SeeedDocument/CAN-BUS-Shield-V2.0/img/CANBUS_V2_Hardware_overview.png

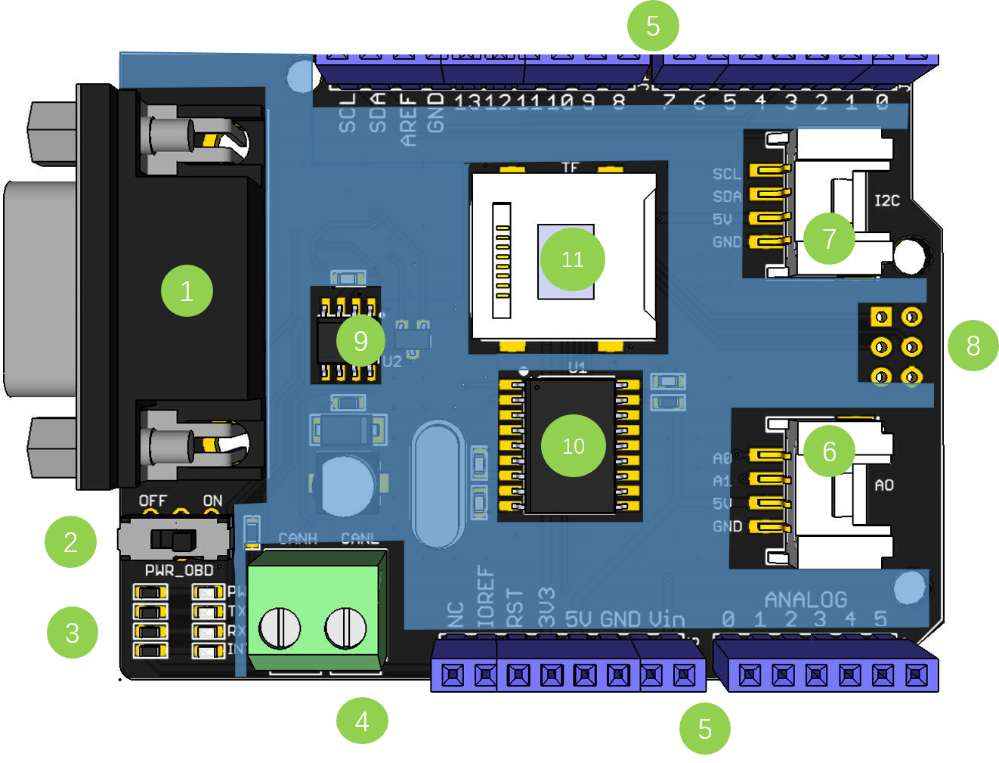
img/CANBUS_V2_Hardware_overview.png
