SeeedDocument/CAN-BUS-Shield-V2.0/img/cs_view.png

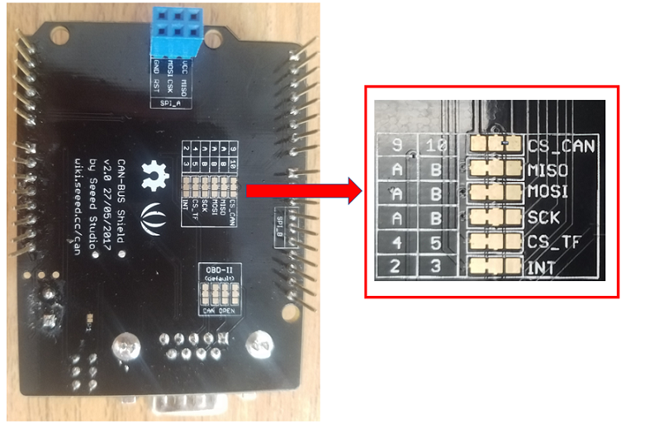
img/cs_view.png
