SeeedDocument/CAN-BUS-Shield-V2.0/img/CAN_BUS_Shield_V2.jpg

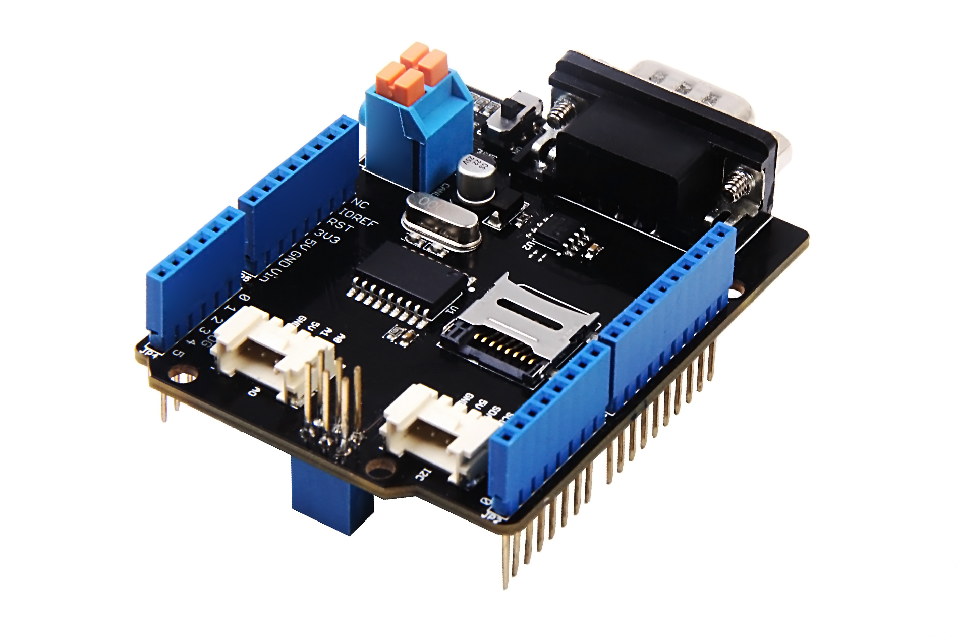
img/CAN_BUS_Shield_V2.jpg
