SeeedDocument/CAN-BUS-Shield-V2.0/img/canbus_arduino.png

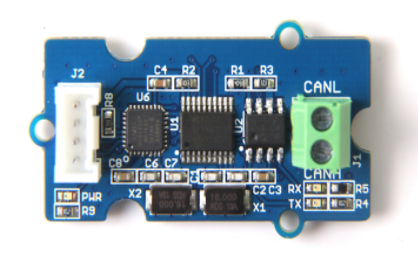
img/canbus_arduino.png
