SeeedDocument/CAN-BUS-Shield-V2.0/img/CP-602U-I_Pin.jpg

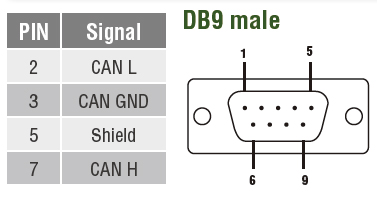
img/CP-602U-I_Pin.jpg
