SeeedDocument/CAN-BUS-Shield-V2.0/img/cs_cut.png

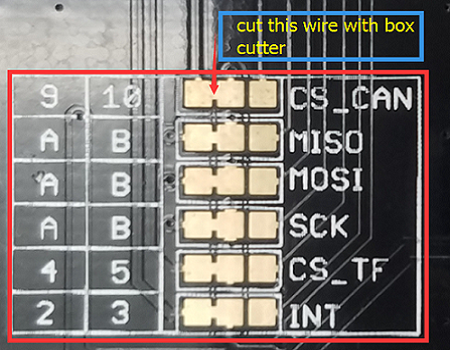
img/cs_cut.png
