SeeedDocument/CAN-BUS-Shield-V2.0/img/drawing2.png

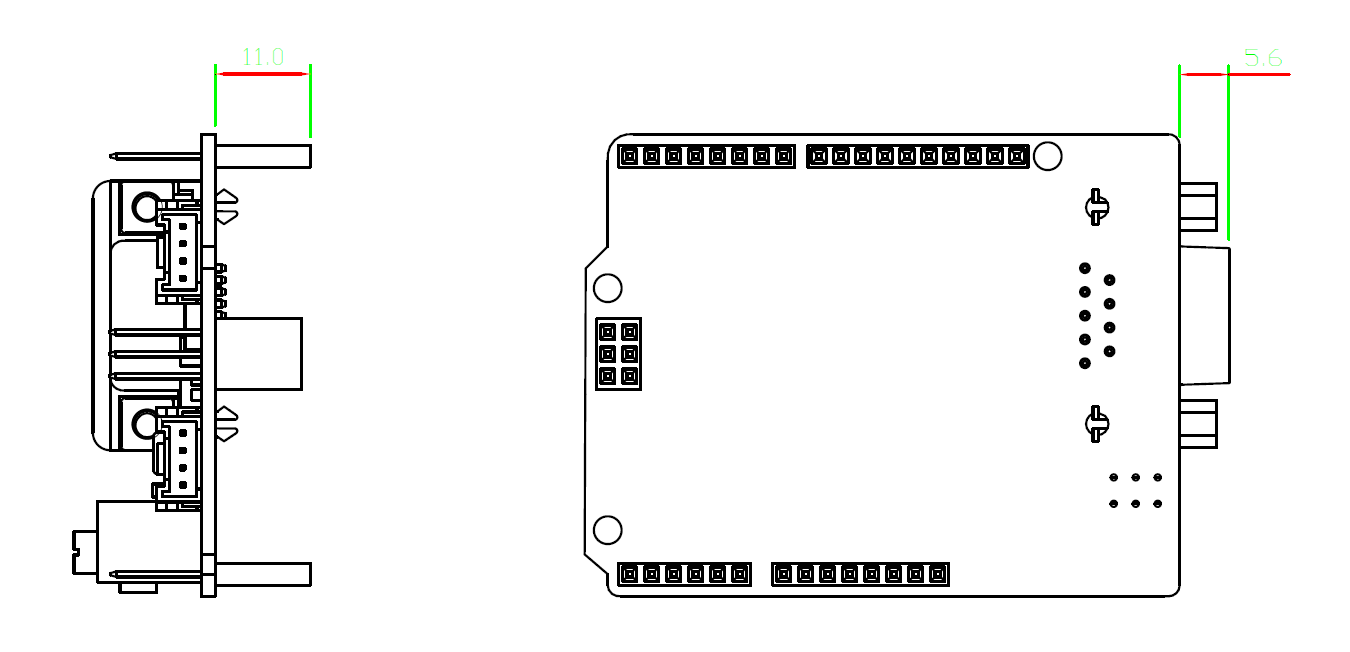
img/drawing2.png
