SeeedDocument/CAN-BUS-Shield-V2.0/img/INT_1.png

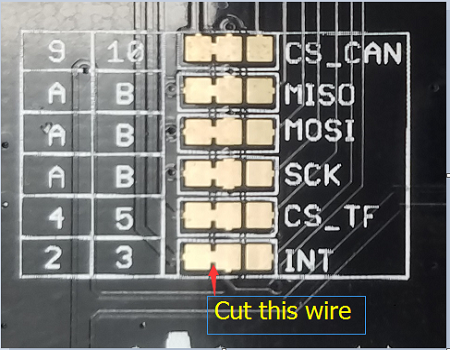
img/INT_1.png
