SeeedDocument/CAN-BUS-Shield-V2.0/img/INT_2.png

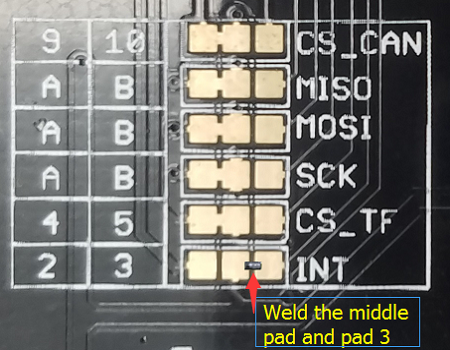
img/INT_2.png
