SeeedDocument/CAN-BUS-Shield-V2.0/img/ODB.png

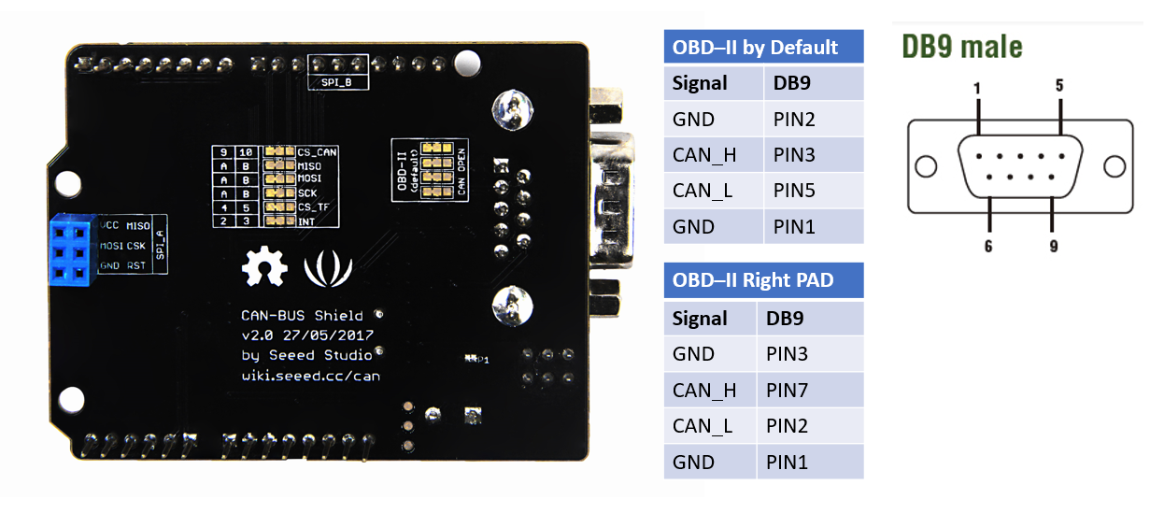
img/ODB.png
