SeeedDocument/CAN-BUS-Shield-V2.0/img/PingMAP_CANBUS_V2.png

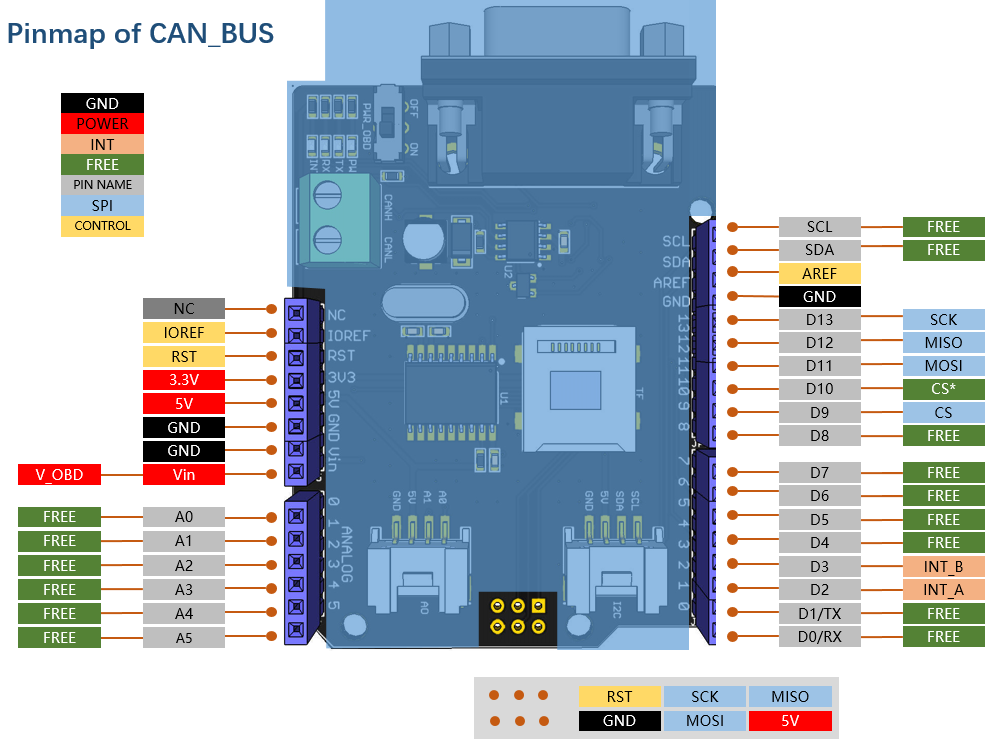
img/PingMAP_CANBUS_V2.png
