SeeedDocument/CAN-BUS-Shield-V2.0/img/weld_cs.png

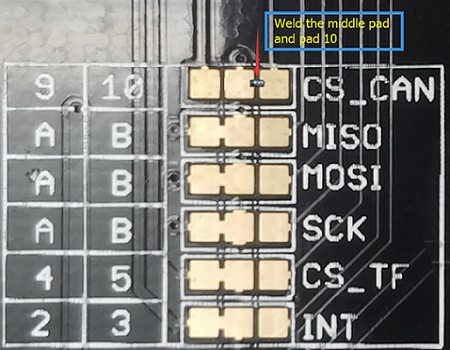
img/weld_cs.png
