SeeedDocument/CAN-BUS-Shield-V2.0/res/CAN-BUS Shield  v2.0.brd

## EAGLE design res/CAN-BUS Shield v2.0.brd

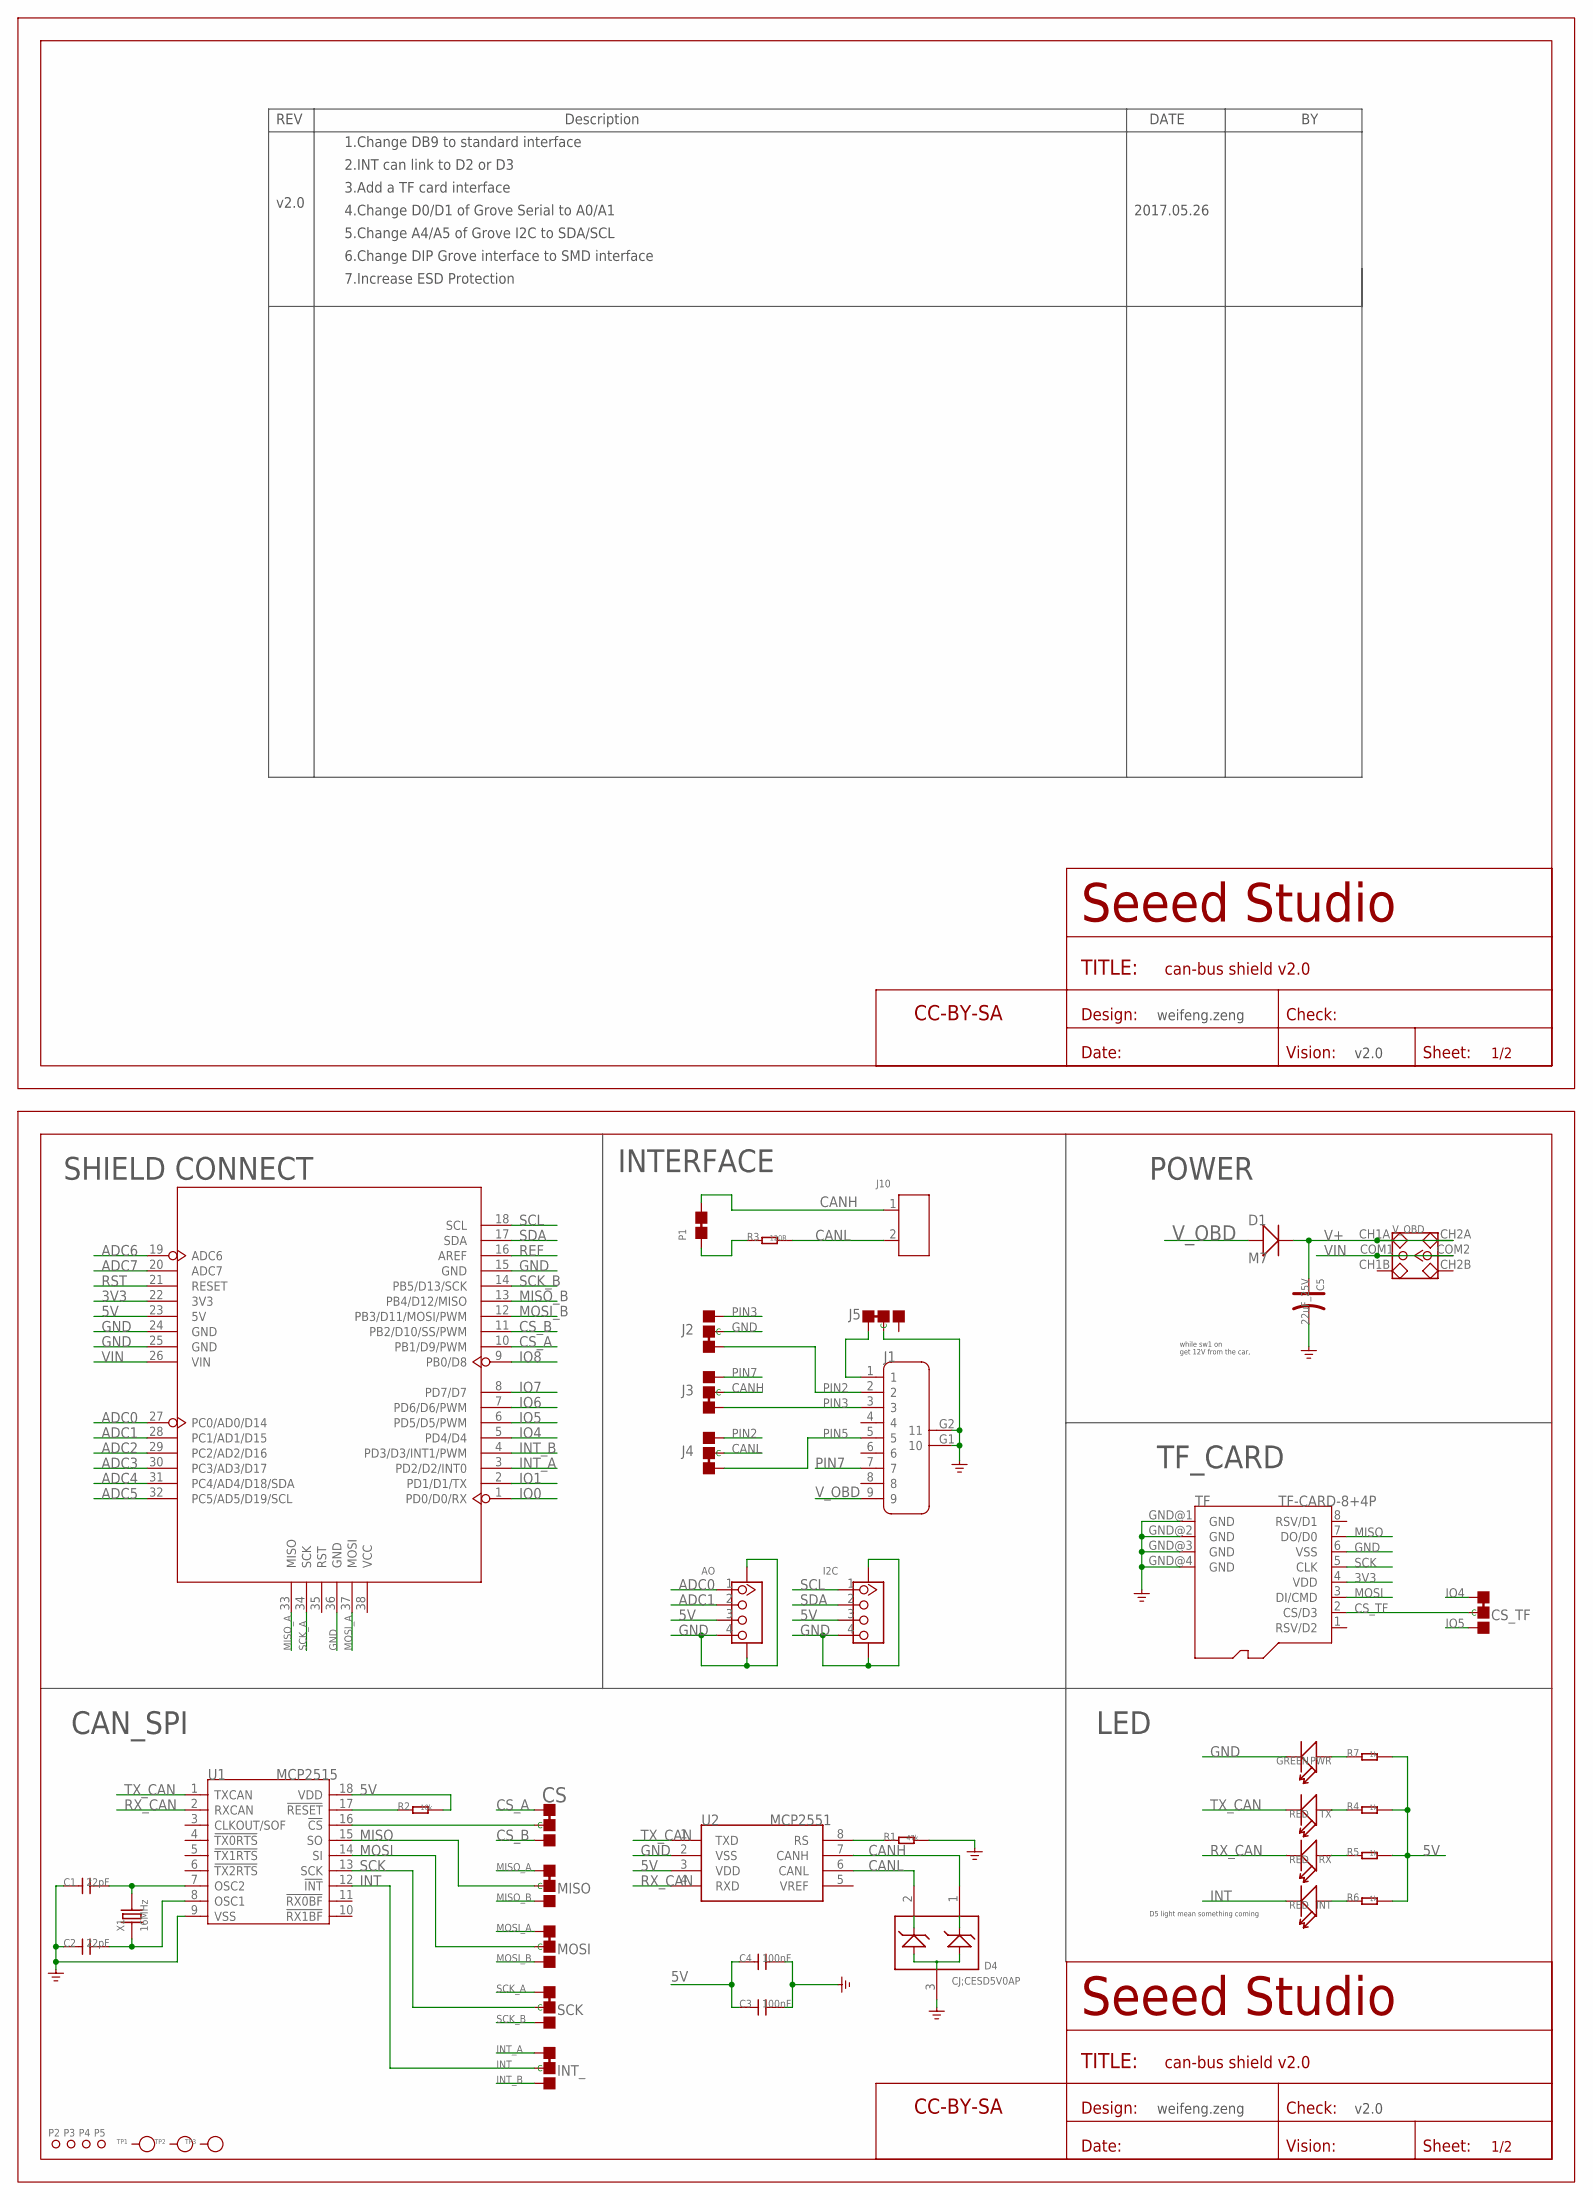
[picture p15: schematic CAN-BUS Shield v2.0.sch, sheet 1]

Parts:
AO: GROVE-CONNECTOR-SMD'90D'; HW4-SMD-2.0-90D
C1, C2: 22pF; 0603
C3, C4: 100nF; 0603
C5: 22uF_25V; ELECTRO-SMD-B-4.8MM
CS: JUMPER-3P-SHORT; 3P-SMD-SHORT
CS_TF: JUMPER-3P-SHORT; 3P-SMD-SHORT
D1: M7; D2010
D4: CJ;CESD5V0AP; SOT-23
I2C: GROVE-CONNECTOR-SMD'90D'; HW4-SMD-2.0-90D
INT: RED; LED-0603
INT_: JUMPER-3P-SHORT; 3P-SMD-SHORT
J1: DB9'MEAL'; DB9-MEAL
J2, J3, J4, J5: JUMPER-3P-SHORT; 3P-SMD-SHORT
J10: SCREW-TERMINAL-2P-10.6X10; H2-5.0-10.6X10X14.8H
MISO: JUMPER-3P-SHORT; 3P-SMD-SHORT
MOSI: JUMPER-3P-SHORT; 3P-SMD-SHORT
P1: JUMPER-2P-SHORT; 2P-SMD-SHORT
P2, P3, P4, P5: PAD-MARK'ANNULAR'; ROUND-MARK-1.0
PWR: GREEN; LED-0603
R1: 47k; 0603
R2: 10k; 0603
R3: 120R; 0603
R4, R5, R6, R7: 1k; 0603
RX: RED; LED-0603
SCK: JUMPER-3P-SHORT; 3P-SMD-SHORT
TF: TF-CARD-8+4P; TF-8+4P-1.1-13.5X15MM
TP1, TP2, TP3: PAD-TEST-POINT'4545'; TP_4545
TX: RED; LED-0603
U1: MCP2515; SOIC18
U2: MCP2551; SOIC8-6.0
U4: ARDUINO-38P'WITH/-SILK'; ARDUINO-38P-WITH/-SILK-500519002
U$5, U$7: SEEEDSTUDIO-OPEN-SCH-FRAME; SEEEDSTUDIO-PCB-FRAME
V_OBD: SWITCH-2CH-6P; 6P-2CH-2.54-7.6X3.0
X1: 16MHz; HC49/S

Connections:
3V3: TF.4 (VDD), U4.22 (3V3)
5V: AO.3, C3.1, C4.1, I2C.3, R2.2, R4.2, R5.2, R6.2, R7.2, U1.18 (VDD), U2.3 (VDD), U4.23 (5V)
ADC0: AO.1, U4.27 (PC0/AD0/D14)
ADC1: AO.2, U4.28 (PC1/AD1/D15)
ADC2: U4.29 (PC2/AD2/D16)
ADC3: U4.30 (PC3/AD3/D17)
ADC4: U4.31 (PC4/AD4/D18/SDA)
ADC5: U4.32 (PC5/AD5/D19/SCL)
ADC6: U4.19 (ADC6)
ADC7: U4.20 (ADC7)
CANH: D4.1, J3.MM (C), J10.1, P1.2, U2.7 (CANH)
CANL: D4.2, J4.MM (C), J10.2, R3.2, U2.6 (CANL)
CS_A: CS.11 (L), U4.10 (PB1/D9/PWM)
CS_B: CS.00 (R), U4.11 (PB2/D10/SS/PWM)
CS_TF: CS_TF.MM (C), TF.2 (CS/D3)
GND: AO.4, AO.SS1, AO.SS2, C1.1, C2.1, C3.2, C4.2, C5.-, D4.3, I2C.4, I2C.SS1, I2C.SS2, J1.G1 (10), J1.G2 (11), J2.MM (C), J5.MM (C), PWR.-, R1.2, TF.6 (VSS), TF.GND@1 (GND), TF.GND@2 (GND), TF.GND@3 (GND), TF.GND@4 (GND), U1.9 (VSS), U2.2 (VSS), U4.15 (GND), U4.24 (GND), U4.25 (GND), U4.36 (GND)
INT: INT.-, INT_.MM (C), U1.12 (!INT)
INT_A: INT_.11 (L), U4.3 (PD2/D2/INT0)
INT_B: INT_.00 (R), U4.4 (PD3/D3/INT1/PWM)
IO0: U4.1 (PD0/D0/RX)
IO1: U4.2 (PD1/D1/TX)
IO4: CS_TF.11 (L), U4.5 (PD4/D4)
IO5: CS_TF.00 (R), U4.6 (PD5/D5/PWM)
IO6: U4.7 (PD6/D6/PWM)
IO7: U4.8 (PD7/D7)
IO8: U4.9 (PB0/D8)
MISO: MISO.MM (C), TF.7 (DO/D0), U1.15 (SO)
MISO_A: MISO.11 (L), U4.33 (MISO)
MISO_B: MISO.00 (R), U4.13 (PB4/D12/MISO)
MOSI: MOSI.MM (C), TF.3 (DI/CMD), U1.14 (SI)
MOSI_A: MOSI.11 (L), U4.37 (MOSI)
MOSI_B: MOSI.00 (R), U4.12 (PB3/D11/MOSI/PWM)
unnamed: PWR.+, R7.1
unnamed: R4.1, TX.+
unnamed: P1.1, R3.1
unnamed: J1.1, J5.11 (L)
unnamed: CS.MM (C), U1.16 (!CS)
unnamed: R5.1, RX.+
unnamed: C1.2, U1.7 (OSC2), X1.2
unnamed: C2.2, U1.8 (OSC1), X1.1
unnamed: INT.+, R6.1
unnamed: R1.1, U2.8 (RS)
PIN2: J1.2, J2.11 (L), J4.00 (R)
PIN3: J1.3, J2.00 (R), J3.11 (L)
PIN5: J1.5, J4.11 (L)
PIN7: J1.7, J3.00 (R)
REF: U4.16 (AREF)
RST: U4.21 (RESET)
RST_N: R2.1, U1.17 (!RESET)
RX_CAN: RX.-, U1.2 (RXCAN), U2.4 (RXD)
SCK: SCK.MM (C), TF.5 (CLK), U1.13 (SCK)
SCK_A: SCK.11 (L), U4.34 (SCK)
SCK_B: SCK.00 (R), U4.14 (PB5/D13/SCK)
SCL: I2C.1, U4.18 (SCL)
SDA: I2C.2, U4.17 (SDA)
TX_CAN: TX.-, U1.1 (TXCAN), U2.1 (TXD)
V+: C5.+, D1.-, V_OBD.CH1A, V_OBD.CH2A
VIN: U4.26 (VIN), V_OBD.COM1, V_OBD.COM2
V_OBD: D1.+, J1.9

Notes on the sheet:
CAN_SPI
SHIELD CONNECT
INTERFACE
POWER
get 12V from the car,
D5 light mean something coming
while sw1 on
TF_CARD
LED
v2.0
1.Change DB9 to standard interface
2.INT can link to D2 or D3
3.Add a TF card interface
4.Change D0/D1 of Grove Serial to A0/A1
5.Change A4/A5 of Grove I2C to SDA/SCL
6.Change DIP Grove interface to SMD interface
2017.05.26
7.Increase ESD Protection
weifeng.zeng

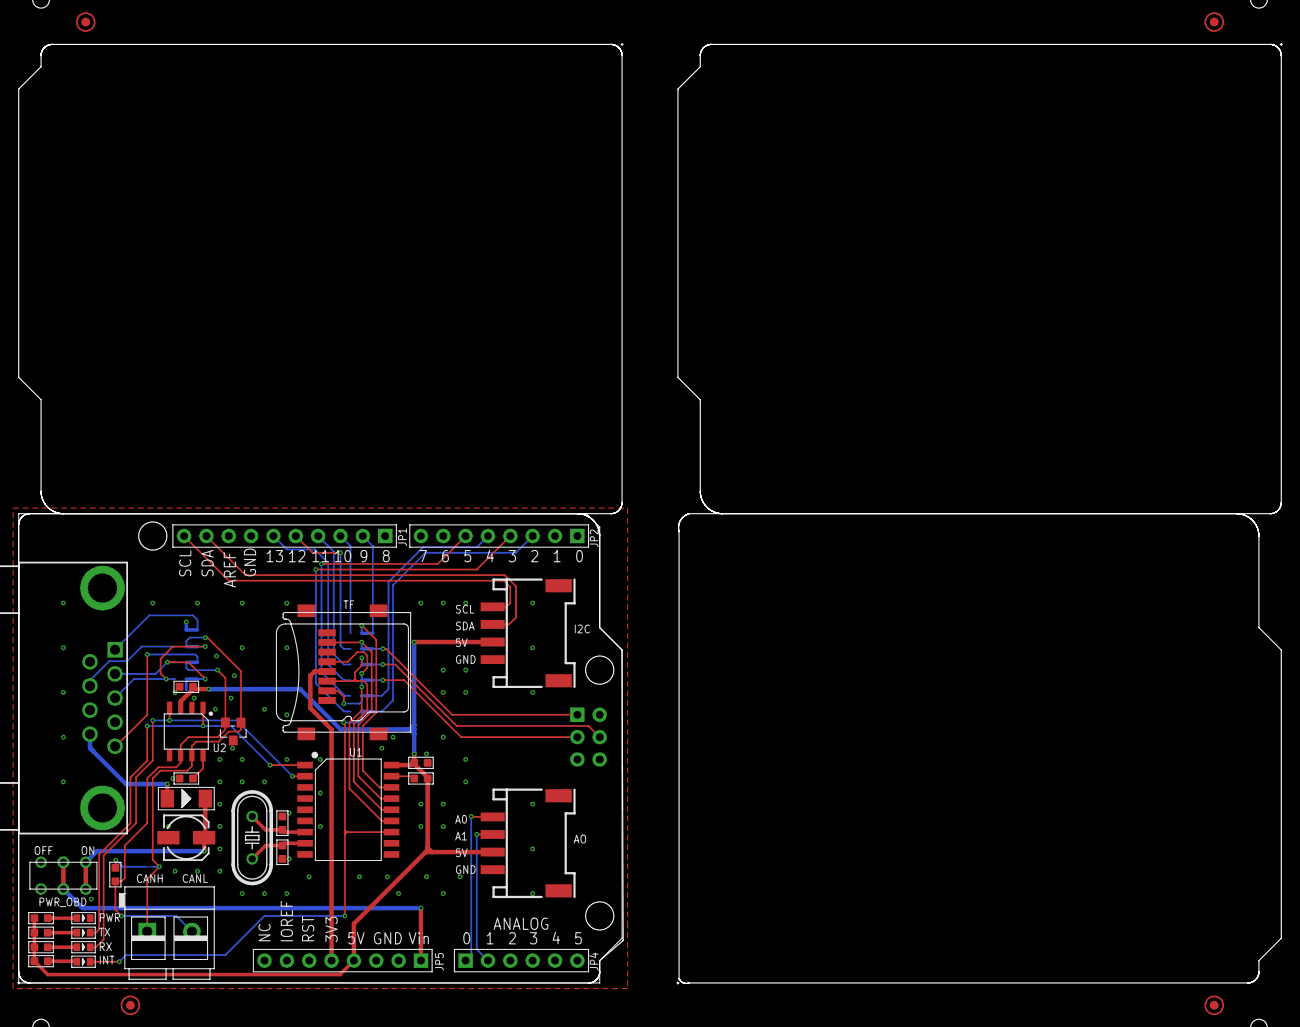
[picture p16: board CAN-BUS Shield v2.0.brd from above]

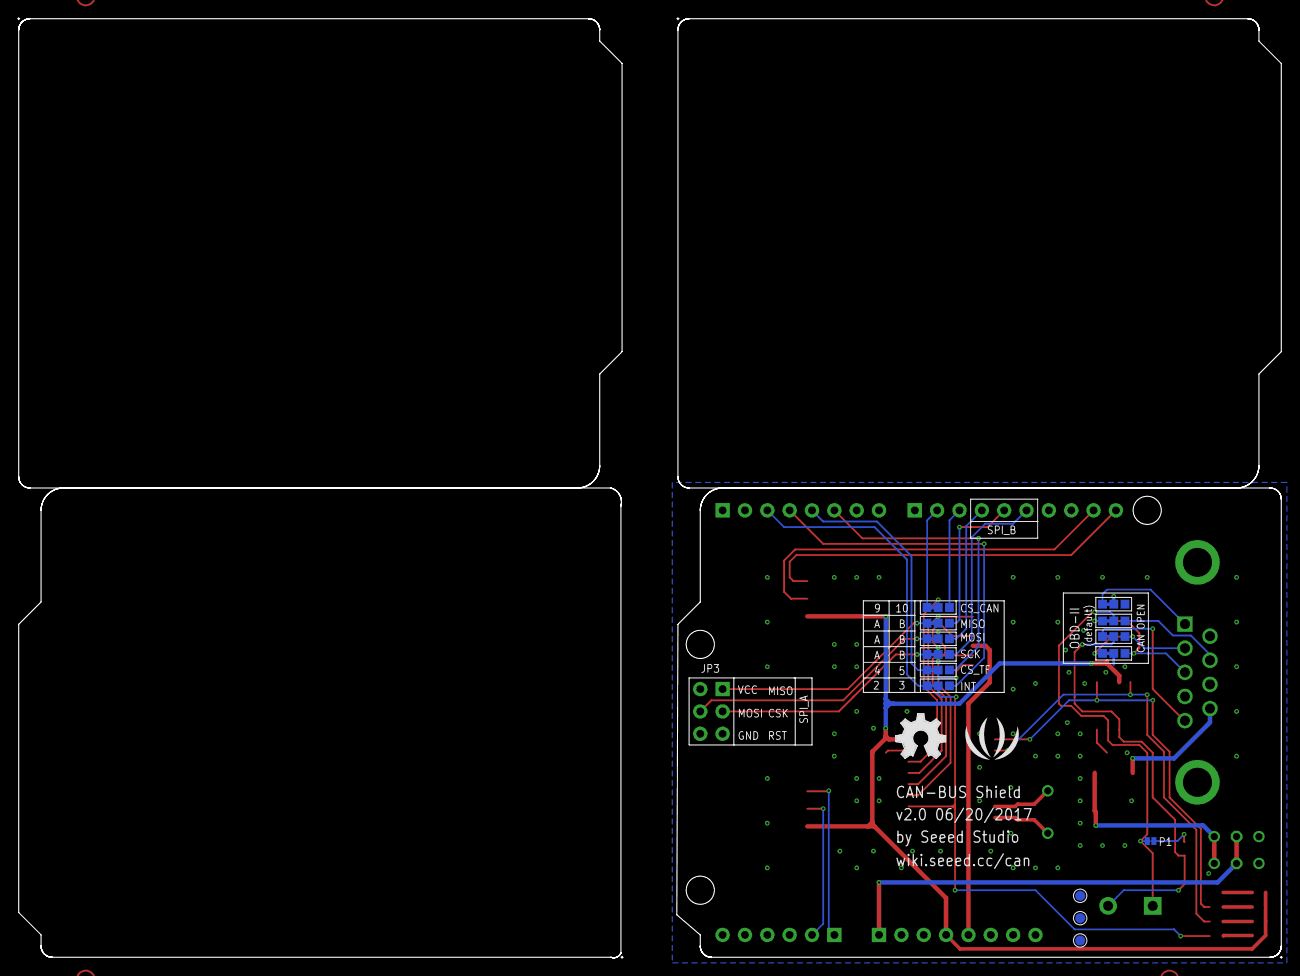
[picture p17: board CAN-BUS Shield v2.0.brd from below]

Board: 2 copper layers, 143.8 x 106.9 mm, 50 parts (16 on the bottom side), 46 nets.

Other parts of the board:
U$1: LOGO_SILK
U$2: GND_POWER; OSHW_FILLX200_NOTEXT
